gokberkkatirci/CAN-and-isoSPI-Adapter/docs/images/board-r0a.png

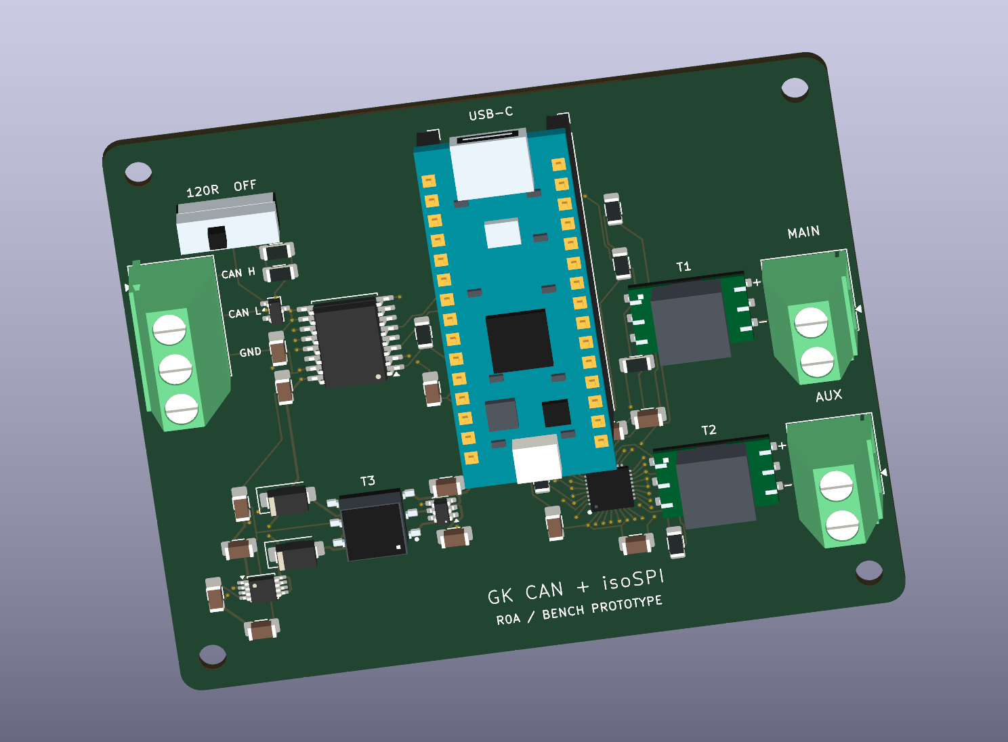
docs/images/board-r0a.png
