gokberkkatirci/CAN-and-isoSPI-Adapter/docs/images/board-r0b.png

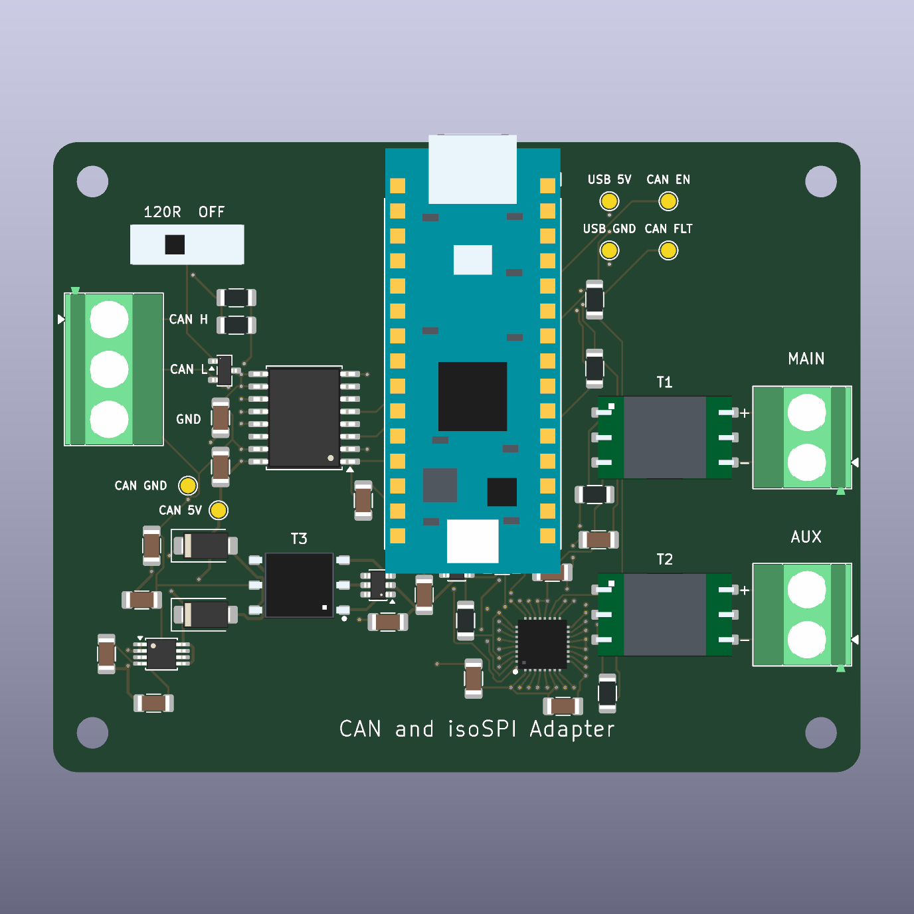
docs/images/board-r0b.png
