gokberkkatirci/CAN-and-isoSPI-Adapter/docs/images/board-r0c.png

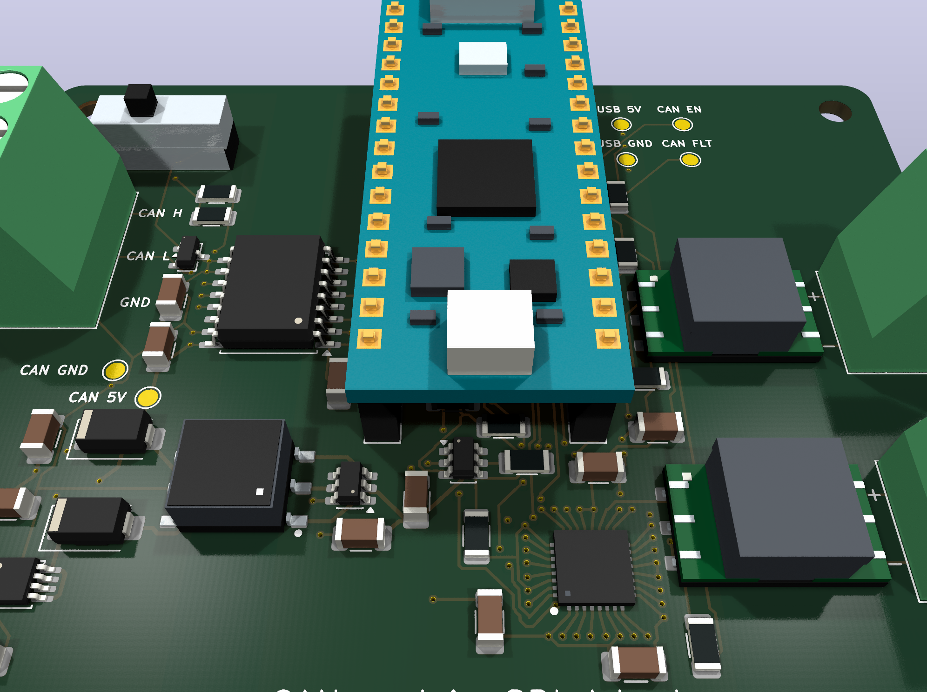
docs/images/board-r0c.png
