gokberkkatirci/CAN-and-isoSPI-Adapter/manufacturing/prototype/T41-R0A/bom-jlcpcb.csv

Comment | Designator | Footprint | JLCPCB Part #
CL31A106KBHNNNE | C1,C4,C103,C105,C106,C203,C205,C206,C303,C305,C306,C403,C405,C406,C503,C505,C506,C603,C605,C606 | C_1206_3216Metric | C13585
CL31B104KBCNNNC | C2,C5,C102,C104,C107,C108,C109,C202,C204,C207,C208,C209,C302,C304,C307,C308,C309,C402,C404,C407,C408,C409,C412,C502,C504,C507,C508,C509,C512,C602,C604,C607,C608,C609,C612,C701,C702,C704,C706,C801,C802,C804,C806,C901,C902,C904,C906 | C_1206_3216Metric | C24497
1206B472K202NT | C3,C101,C201,C301,C401,C501,C601 | C_1206_3216Metric | C41017
CC1206JKNPOCBN220 | C410,C411,C510,C511,C610,C611 | C_1206_3216Metric | C107174
CL31B105KBHNNNE | C703,C705,C803,C805,C903,C905 | C_1206_3216Metric | C1848
SMAJ5.0A | D1 | D_SMA | C83329
B5819W SL | D2,D101,D102,D201,D202,D301,D302,D401,D402,D501,D502,D601,D602 | D_SOD-123 | C8598
KT-1206G | D3,D4,D104,D204,D304,D404,D504,D604 | LED_1206_3216Metric | C14641
KT-1206R | D5 | LED_1206_3216Metric | C49018
PESD2CANFD24V-TR | D103,D203,D303,D403,D503,D603 | SOT-23 | C552486
1206L200PR | F1 | Fuse_1206_3216Metric | C151163
TYPE-C-31-M-12 | J1 | USB_C_Receptacle_HRO_TYPE-C-31-M-12 | C165948
HC-PM254-8.5H-1x24PZ | J2,J3 | PinSocket_1x24_P2.54mm_Vertical | C41376163
YTC1P-8535-01 | J4,J5 | Pogo_YTC1P-8535_D2.0mm | C5221289
DS1034-09FBN044 | J101,J201,J301,J401,J501,J601 | DSUB-9_Socket_Vertical_P2.77x2.84mm_MountingHoles | C19268322
1715721 | J701,J702,J801,J802,J901,J902 | TerminalBlock_Phoenix_MKDS-1,5-2-5.08_1x02_P5.08mm_Horizontal | C480516
1206W4F5101T5E | R1,R2 | R_1206_3216Metric | C26033
1206W4F1001T5E | R3,R4,R7,R8 | R_1206_3216Metric | C4410
1206W4F1004T5E | R5,R103,R203,R303,R403,R503,R603 | R_1206_3216Metric | C17927
1206W4F2201T5E | R6,R107,R207,R307,R407,R507,R607 | R_1206_3216Metric | C17948
1206W4F1002T5E | R9,R106,R206,R306,R406,R408,R409,R506,R508,R509,R606,R608,R609,R701,R702,R801,R802,R901,R902 | R_1206_3216Metric | C17902
1206W4F2400T5E | R101,R102,R201,R202,R301,R302,R401,R402,R501,R502,R601,R602 | R_1206_3216Metric | C17961
1206W4F1303T5E | R104,R204,R304,R404,R504,R604 | R_1206_3216Metric | C82092
1206W4F1003T5E | R105,R205,R305,R405,R505,R605 | R_1206_3216Metric | C17900
1206W4F1000T5E | R703,R704,R803,R804,R903,R904 | R_1206_3216Metric | C17901
EG1218 | SW101,SW201,SW301,SW401,SW501,SW601 | EG1218 | C273394
760390014 | T101,T201,T301,T401,T501,T601 | WE_760390014 | C2802211
SM91801AL-E | T701,T702,T801,T802,T901,T902 | SM91801AL-E | C26423704
USBLC6-2SC6 | U1 | SOT-23-6 | C7519
ISO1042DWR | U101,U201,U301,U401,U501,U601 | SOIC-16W_7.5x10.3mm_P1.27mm | C1848126
TPS2553DBVR | U102,U202,U302,U402,U502,U602 | SOT-23-6 | C55266
SN6505BDBVR | U103,U203,U303,U403,U503,U603 | SOT-23-6 | C74518
TLV76750DGNR | U104,U204,U304,U404,U504,U604 | MSOP-8-1EP_3x3mm_P0.65mm_EP1.73x1.85mm | C3752807
MCP2518FDT-E/SL | U405,U505,U605 | SOIC-14_3.9x8.7mm_P1.27mm | C626758
ADBMS6822WCCSZ-RL | U701,U801,U901 | ADBMS6822_05-08-7057 | C19190031
X322540MPB4SI | Y401,Y501,Y601 | Crystal_SMD_3225-4Pin_3.2x2.5mm | C9010
