gokberkkatirci/CAN-and-isoSPI-Adapter/hardware/teensy41/CAN6_isoSPI6_T41.kicad_pcb

## KiCad design hardware/teensy41/CAN6_isoSPI6_T41.kicad_pcb (2026-11-09)

Schematic: CAN6_isoSPI6_T41.kicad_sch, Six CAN and six isoSPI adapter - Teensy 4.1

Parts:
C1, C4, C103, C105, C106, C203, C205, C206, C303, C305, C306, C403, C405, C406, C503, C505, C506, C603, C605, C606: 10uF; C_1206_3216Metric; MPN CL31A106KBHNNNE; JLCPCB Part # C13585
C2, C5, C102, C104, C107, C108, C109, C202, C204, C207, C208, C209, C302, C304, C307, C308, C309, C402, C404, C407, C408, C409, C412, C502, C504, C507, C508, C509, C512, C602, C604, C607, C608, C609, C612, C701, C702, C704, C706, C801, C802, C804, C806, C901, C902, C904, C906: 100nF; C_1206_3216Metric; MPN CL31B104KBCNNNC; JLCPCB Part # C24497
C3, C101, C201, C301, C401, C501, C601: 4.7nF 2kV; C_1206_3216Metric; MPN 1206B472K202NT; JLCPCB Part # C41017
C410, C411, C510, C511, C610, C611: 22pF; C_1206_3216Metric; MPN CC1206JKNPOCBN220; JLCPCB Part # C107174
C703, C705, C803, C805, C903, C905: 1uF; C_1206_3216Metric; MPN CL31B105KBHNNNE; JLCPCB Part # C1848
D1: SMAJ5.0A; D_SMA; MPN SMAJ5.0A; JLCPCB Part # C83329
D2, D101, D102, D201, D202, D301, D302, D401, D402, D501, D502, D601, D602: B5819W; D_SOD-123; MPN B5819W SL; JLCPCB Part # C8598
D3, D4, D104, D204, D304, D404, D504, D604: Green; LED_1206_3216Metric; MPN KT-1206G; JLCPCB Part # C14641
D5: Red; LED_1206_3216Metric; MPN KT-1206R; JLCPCB Part # C49018
D103, D203, D303, D403, D503, D603: PESD2CANFD24V-TR; SOT-23; MPN PESD2CANFD24V-TR; JLCPCB Part # C552486
F1: 2A PTC; Fuse_1206_3216Metric; MPN 1206L200PR; JLCPCB Part # C151163
H1, H2, H3, H4, H5, H6: M3 mounting hole; MountingHole_3.2mm_M3
J1: USB-C; USB_C_Receptacle_HRO_TYPE-C-31-M-12; MPN TYPE-C-31-M-12; JLCPCB Part # C165948
J2: Teensy 4.1 row GND-0-32; PinSocket_1x24_P2.54mm_Vertical; MPN HC-PM254-8.5H-1x24PZ; JLCPCB Part # C41376163
J3: Teensy 4.1 row VIN-23-33; PinSocket_1x24_P2.54mm_Vertical; MPN HC-PM254-8.5H-1x24PZ; JLCPCB Part # C41376163
J4: Pogo USB D-; Pogo_YTC1P-8535_D2.0mm; MPN YTC1P-8535-01; JLCPCB Part # C5221289
J5: Pogo USB D+; Pogo_YTC1P-8535_D2.0mm; MPN YTC1P-8535-01; JLCPCB Part # C5221289
J101: CAN1 DSUB-9F; DSUB-9_Socket_Vertical_P2.77x2.84mm_MountingHoles; MPN DS1034-09FBN044; JLCPCB Part # C19268322
J201: CAN2 DSUB-9F; DSUB-9_Socket_Vertical_P2.77x2.84mm_MountingHoles; MPN DS1034-09FBN044; JLCPCB Part # C19268322
J301: CAN3 DSUB-9F; DSUB-9_Socket_Vertical_P2.77x2.84mm_MountingHoles; MPN DS1034-09FBN044; JLCPCB Part # C19268322
J401: CAN4 DSUB-9F; DSUB-9_Socket_Vertical_P2.77x2.84mm_MountingHoles; MPN DS1034-09FBN044; JLCPCB Part # C19268322
J501: CAN5 DSUB-9F; DSUB-9_Socket_Vertical_P2.77x2.84mm_MountingHoles; MPN DS1034-09FBN044; JLCPCB Part # C19268322
J601: CAN6 DSUB-9F; DSUB-9_Socket_Vertical_P2.77x2.84mm_MountingHoles; MPN DS1034-09FBN044; JLCPCB Part # C19268322
J701: isoSPI 1; TerminalBlock_Phoenix_MKDS-1,5-2-5.08_1x02_P5.08mm_Horizont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; MPN 1715721; JLCPCB Part # C480516
J702: isoSPI 2; TerminalBlock_Phoenix_MKDS-1,5-2-5.08_1x02_P5.08mm_Horizont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; MPN 1715721; JLCPCB Part # C480516
J801: isoSPI 3; TerminalBlock_Phoenix_MKDS-1,5-2-5.08_1x02_P5.08mm_Horizont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; MPN 1715721; JLCPCB Part # C480516
J802: isoSPI 4; TerminalBlock_Phoenix_MKDS-1,5-2-5.08_1x02_P5.08mm_Horizont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; MPN 1715721; JLCPCB Part # C480516
J901: isoSPI 5; TerminalBlock_Phoenix_MKDS-1,5-2-5.08_1x02_P5.08mm_Horizont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; MPN 1715721; JLCPCB Part # C480516
J902: isoSPI 6; TerminalBlock_Phoenix_MKDS-1,5-2-5.08_1x02_P5.08mm_Horizont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; MPN 1715721; JLCPCB Part # C480516
R1, R2: 5.1k; R_1206_3216Metric; MPN 1206W4F5101T5E; JLCPCB Part # C26033
R3, R4, R7, R8: 1k; R_1206_3216Metric; MPN 1206W4F1001T5E; JLCPCB Part # C4410
R5, R103, R203, R303, R403, R503, R603: 1M; R_1206_3216Metric; MPN 1206W4F1004T5E; JLCPCB Part # C17927
R6, R107, R207, R307, R407, R507, R607: 2.2k; R_1206_3216Metric; MPN 1206W4F2201T5E; JLCPCB Part # C17948
R9, R106, R206, R306, R406, R408, R409, R506, R508, R509, R606, R608, R609, R701, R702, R801, R802, R901, R902: 10k; R_1206_3216Metric; MPN 1206W4F1002T5E; JLCPCB Part # C17902
R101, R102, R201, R202, R301, R302, R401, R402, R501, R502, R601, R602: 240R; R_1206_3216Metric; MPN 1206W4F2400T5E; JLCPCB Part # C17961
R104, R204, R304, R404, R504, R604: 130k; R_1206_3216Metric; MPN 1206W4F1303T5E; JLCPCB Part # C82092
R105, R205, R305, R405, R505, R605: 100k; R_1206_3216Metric; MPN 1206W4F1003T5E; JLCPCB Part # C17900
R703, R704, R803, R804, R903, R904: 100R; R_1206_3216Metric; MPN 1206W4F1000T5E; JLCPCB Part # C17901
SW101, SW201, SW301, SW401, SW501, SW601: 120R termination; EG1218; MPN EG1218; JLCPCB Part # C273394
T101, T201, T301, T401, T501, T601: 760390014; WE_760390014; MPN 760390014; JLCPCB Part # C2802211
T701, T702, T801, T802, T901, T902: SM91801AL-E; MPN SM91801AL-E; JLCPCB Part # C26423704
TP1, TP2, TP3, TP4, TP5, TP6, TP7, TP8, TP9, TP10, TP11, TP12, TP13, TP14, TP15, TP16: Test pad; TestPoint_Pad_D1.5mm
U1: USBLC6-2SC6; SOT-23-6; MPN USBLC6-2SC6; JLCPCB Part # C7519
U101, U201, U301, U401, U501, U601: ISO1042DWR; SOIC-16W_7.5x10.3mm_P1.27mm; MPN ISO1042DWR; JLCPCB Part # C1848126
U102, U202, U302, U402, U502, U602: TPS2553DBVR; SOT-23-6; MPN TPS2553DBVR; JLCPCB Part # C55266
U103, U203, U303, U403, U503, U603: SN6505BDBVR; SOT-23-6; MPN SN6505BDBVR; JLCPCB Part # C74518
U104, U204, U304, U404, U504, U604: TLV76750DGNR; MSOP-8-1EP_3x3mm_P0.65mm_EP1.73x1.85mm; MPN TLV76750DGNR; JLCPCB Part # C3752807
U405, U505, U605: MCP2518FDT-E/SL; SOIC-14_3.9x8.7mm_P1.27mm; MPN MCP2518FDT-E/SL; JLCPCB Part # C626758
U701, U801, U901: ADBMS6822WCCSZ-RL; ADBMS6822_05-08-7057; MPN ADBMS6822WCCSZ-RL; JLCPCB Part # C19190031
Y401, Y501, Y601: 40MHz; Crystal_SMD_3225-4Pin_3.2x2.5mm; MPN X322540MPB4SI; JLCPCB Part # C9010

Connections:
/+3V3: C4.1, C5.1, C109.1, C209.1, C309.1, C409.1, C412.1, C509.1, C512.1, C609.1, C612.1, C701.1, C702.1, C801.1, C802.1, C901.1, C902.1, J2.15 (3V3), J3.3 (3V3), R9.2, R106.2, R206.2, R306.2, R406.2, R408.2, R409.2, R506.2, R508.2, R509.2, R606.2, R608.2, R609.2, R701.2, R702.2, R801.2, R802.2, R901.2, R902.2, TP3.1, U101.1 (VCC1), U201.1 (VCC1), U301.1 (VCC1), U401.1 (VCC1), U405.14 (VDD), U501.1 (VCC1), U505.14 (VDD), U601.1 (VCC1), U605.14 (VDD), U701.1 (MSTR), U701.6 (VDDS), U701.25 (MSTR2), U701.30 (VDDS2), U801.1 (MSTR), U801.6 (VDDS), U801.25 (MSTR2), U801.30 (VDDS2), U901.1 (MSTR), U901.6 (VDDS), U901.25 (MSTR2), U901.30 (VDDS2)
/+5V: C1.1, C2.1, C102.1, C202.1, C302.1, C402.1, C502.1, C602.1, C703.1, C704.1, C705.1, C706.1, C803.1, C804.1, C805.1, C806.1, C903.1, C904.1, C905.1, C906.1, D1.1 (K), D2.2 (A), F1.2, R6.1, TP1.1, U102.1 (IN), U202.1 (IN), U302.1 (IN), U402.1 (IN), U502.1 (IN), U602.1 (IN), U701.12 (VDD), U701.13 (VP), U701.20 (VDD2), U701.21 (VP2), U801.12 (VDD), U801.13 (VP), U801.20 (VDD2), U801.21 (VP2), U901.12 (VDD), U901.13 (VP), U901.20 (VDD2), U901.21 (VP2)
/CAN1I_5V: C106.1, C107.1, C108.1, R107.1, U101.11 (VCC2), U101.16 (VCC2), U104.1 (OUT), U104.2 (SNS)
/CAN1I_GND: C101.2, C105.2, C106.2, C107.2, C108.2, D103.3 (COMMON), D104.1 (K), J101.3 (CAN_GND), J101.6 (CAN_GND), R103.2, T101.5 (SEC_CT), U101.9 (GND2), U101.10 (GND2), U101.15 (GND2), U104.4 (GND), U104.6 (GND), U104.9 (EP)
/CAN1I_H: D103.1 (IO1), J101.7 (CAN_H), SW101.2 (COM), U101.13 (CANH)
/CAN1I_L: D103.2 (IO2), J101.2 (CAN_L), R101.2, R102.2, U101.12 (CANL)
/CAN1I_LED: D104.2 (A), R107.2
/CAN1I_RA: D101.2 (A), T101.6 (SEC1)
/CAN1I_RB: D102.2 (A), T101.4 (SEC2)
/CAN1I_RECT: C105.1, D101.1 (K), D102.1 (K), U104.5 (EN), U104.8 (IN)
/CAN1I_SHLD: C101.1, J101.5 (SHLD), J101.SH (SHELL), R103.1
/CAN1I_TERM: R101.1, R102.1, SW101.1 (ON)
/CAN1_EN: J3.10 (D17), R105.1, U102.3 (EN)
/CAN1_ILIM: R104.1, U102.5 (ILIM)
/CAN1_PPA: T101.3 (PRI2), U103.1 (D1)
/CAN1_PPB: T101.1 (PRI1), U103.3 (D2)
/CAN1_PWR: C103.1, C104.1, T101.2 (PRI_CT), U102.6 (OUT), U103.2 (VCC), U103.5 (EN)
/CAN1_RX: J3.4 (D23), TP13.1, U101.5 (RXD)
/CAN1_TX: J3.5 (D22), R106.1, TP12.1, U101.3 (TXD)
/CAN2I_5V: C206.1, C207.1, C208.1, R207.1, U201.11 (VCC2), U201.16 (VCC2), U204.1 (OUT), U204.2 (SNS)
/CAN2I_GND: C201.2, C205.2, C206.2, C207.2, C208.2, D203.3 (COMMON), D204.1 (K), J201.3 (CAN_GND), J201.6 (CAN_GND), R203.2, T201.5 (SEC_CT), U201.9 (GND2), U201.10 (GND2), U201.15 (GND2), U204.4 (GND), U204.6 (GND), U204.9 (EP)
/CAN2I_H: D203.1 (IO1), J201.7 (CAN_H), SW201.2 (COM), U201.13 (CANH)
/CAN2I_L: D203.2 (IO2), J201.2 (CAN_L), R201.2, R202.2, U201.12 (CANL)
/CAN2I_LED: D204.2 (A), R207.2
/CAN2I_RA: D201.2 (A), T201.6 (SEC1)
/CAN2I_RB: D202.2 (A), T201.4 (SEC2)
/CAN2I_RECT: C205.1, D201.1 (K), D202.1 (K), U204.5 (EN), U204.8 (IN)
/CAN2I_SHLD: C201.1, J201.5 (SHLD), J201.SH (SHELL), R203.1
/CAN2I_TERM: R201.1, R202.1, SW201.1 (ON)
/CAN2_EN: J3.9 (D18), R205.1, U202.3 (EN)
/CAN2_ILIM: R204.1, U202.5 (ILIM)
/CAN2_PPA: T201.3 (PRI2), U203.1 (D1)
/CAN2_PPB: T201.1 (PRI1), U203.3 (D2)
/CAN2_PWR: C203.1, C204.1, T201.2 (PRI_CT), U202.6 (OUT), U203.2 (VCC), U203.5 (EN)
/CAN2_RX: J2.2 (D0), U201.5 (RXD)
/CAN2_TX: J2.3 (D1), R206.1, U201.3 (TXD)
/CAN3I_5V: C306.1, C307.1, C308.1, R307.1, U301.11 (VCC2), U301.16 (VCC2), U304.1 (OUT), U304.2 (SNS)
/CAN3I_GND: C301.2, C305.2, C306.2, C307.2, C308.2, D303.3 (COMMON), D304.1 (K), J301.3 (CAN_GND), J301.6 (CAN_GND), R303.2, T301.5 (SEC_CT), U301.9 (GND2), U301.10 (GND2), U301.15 (GND2), U304.4 (GND), U304.6 (GND), U304.9 (EP)
/CAN3I_H: D303.1 (IO1), J301.7 (CAN_H), SW301.2 (COM), U301.13 (CANH)
/CAN3I_L: D303.2 (IO2), J301.2 (CAN_L), R301.2, R302.2, U301.12 (CANL)
/CAN3I_LED: D304.2 (A), R307.2
/CAN3I_RA: D301.2 (A), T301.6 (SEC1)
/CAN3I_RB: D302.2 (A), T301.4 (SEC2)
/CAN3I_RECT: C305.1, D301.1 (K), D302.1 (K), U304.5 (EN), U304.8 (IN)
/CAN3I_SHLD: C301.1, J301.5 (SHLD), J301.SH (SHELL), R303.1
/CAN3I_TERM: R301.1, R302.1, SW301.1 (ON)
/CAN3_EN: J3.8 (D19), R305.1, U302.3 (EN)
/CAN3_ILIM: R304.1, U302.5 (ILIM)
/CAN3_PPA: T301.3 (PRI2), U303.1 (D1)
/CAN3_PPB: T301.1 (PRI1), U303.3 (D2)
/CAN3_PWR: C303.1, C304.1, T301.2 (PRI_CT), U302.6 (OUT), U303.2 (VCC), U303.5 (EN)
/CAN3_RX: J2.22 (D30), U301.5 (RXD)
/CAN3_TX: J2.23 (D31), R306.1, U301.3 (TXD)
/CAN4I_5V: C406.1, C407.1, C408.1, R407.1, U401.11 (VCC2), U401.16 (VCC2), U404.1 (OUT), U404.2 (SNS)
/CAN4I_GND: C401.2, C405.2, C406.2, C407.2, C408.2, D403.3 (COMMON), D404.1 (K), J401.3 (CAN_GND), J401.6 (CAN_GND), R403.2, T401.5 (SEC_CT), U401.9 (GND2), U401.10 (GND2), U401.15 (GND2), U404.4 (GND), U404.6 (GND), U404.9 (EP)
/CAN4I_H: D403.1 (IO1), J401.7 (CAN_H), SW401.2 (COM), U401.13 (CANH)
/CAN4I_L: D403.2 (IO2), J401.2 (CAN_L), R401.2, R402.2, U401.12 (CANL)
/CAN4I_LED: D404.2 (A), R407.2
/CAN4I_RA: D401.2 (A), T401.6 (SEC1)
/CAN4I_RB: D402.2 (A), T401.4 (SEC2)
/CAN4I_RECT: C405.1, D401.1 (K), D402.1 (K), U404.5 (EN), U404.8 (IN)
/CAN4I_SHLD: C401.1, J401.5 (SHLD), J401.SH (SHELL), R403.1
/CAN4I_TERM: R401.1, R402.1, SW401.1 (ON)
/CAN4_EN: J3.7 (D20), R405.1, U402.3 (EN)
/CAN4_ILIM: R404.1, U402.5 (ILIM)
/CAN4_PPA: T401.3 (PRI2), U403.1 (D1)
/CAN4_PPB: T401.1 (PRI1), U403.3 (D2)
/CAN4_PWR: C403.1, C404.1, T401.2 (PRI_CT), U402.6 (OUT), U403.2 (VCC), U403.5 (EN)
/CAN4_RX: U401.5 (RXD), U405.2 (RXCAN)
/CAN4_TX: R406.1, U401.3 (TXD), U405.1 (TXCAN)
/CAN4_XI: C410.1, U405.6 (OSC1), Y401.1 (X1)
/CAN4_XO: C411.1, U405.5 (OSC2), Y401.3 (X2)
/CAN5I_5V: C506.1, C507.1, C508.1, R507.1, U501.11 (VCC2), U501.16 (VCC2), U504.1 (OUT), U504.2 (SNS)
/CAN5I_GND: C501.2, C505.2, C506.2, C507.2, C508.2, D503.3 (COMMON), D504.1 (K), J501.3 (CAN_GND), J501.6 (CAN_GND), R503.2, T501.5 (SEC_CT), U501.9 (GND2), U501.10 (GND2), U501.15 (GND2), U504.4 (GND), U504.6 (GND), U504.9 (EP)
/CAN5I_H: D503.1 (IO1), J501.7 (CAN_H), SW501.2 (COM), U501.13 (CANH)
/CAN5I_L: D503.2 (IO2), J501.2 (CAN_L), R501.2, R502.2, U501.12 (CANL)
/CAN5I_LED: D504.2 (A), R507.2
/CAN5I_RA: D501.2 (A), T501.6 (SEC1)
/CAN5I_RB: D502.2 (A), T501.4 (SEC2)
/CAN5I_RECT: C505.1, D501.1 (K), D502.1 (K), U504.5 (EN), U504.8 (IN)
/CAN5I_SHLD: C501.1, J501.5 (SHLD), J501.SH (SHELL), R503.1
/CAN5I_TERM: R501.1, R502.1, SW501.1 (ON)
/CAN5_EN: J3.6 (D21), R505.1, U502.3 (EN)
/CAN5_ILIM: R504.1, U502.5 (ILIM)
/CAN5_PPA: T501.3 (PRI2), U503.1 (D1)
/CAN5_PPB: T501.1 (PRI1), U503.3 (D2)
/CAN5_PWR: C503.1, C504.1, T501.2 (PRI_CT), U502.6 (OUT), U503.2 (VCC), U503.5 (EN)
/CAN5_RX: U501.5 (RXD), U505.2 (RXCAN)
/CAN5_TX: R506.1, U501.3 (TXD), U505.1 (TXCAN)
/CAN5_XI: C510.1, U505.6 (OSC1), Y501.1 (X1)
/CAN5_XO: C511.1, U505.5 (OSC2), Y501.3 (X2)
/CAN6I_5V: C606.1, C607.1, C608.1, R607.1, U601.11 (VCC2), U601.16 (VCC2), U604.1 (OUT), U604.2 (SNS)
/CAN6I_GND: C601.2, C605.2, C606.2, C607.2, C608.2, D603.3 (COMMON), D604.1 (K), J601.3 (CAN_GND), J601.6 (CAN_GND), R603.2, T601.5 (SEC_CT), U601.9 (GND2), U601.10 (GND2), U601.15 (GND2), U604.4 (GND), U604.6 (GND), U604.9 (EP)
/CAN6I_H: D603.1 (IO1), J601.7 (CAN_H), SW601.2 (COM), U601.13 (CANH)
/CAN6I_L: D603.2 (IO2), J601.2 (CAN_L), R601.2, R602.2, U601.12 (CANL)
/CAN6I_LED: D604.2 (A), R607.2
/CAN6I_RA: D601.2 (A), T601.6 (SEC1)
/CAN6I_RB: D602.2 (A), T601.4 (SEC2)
/CAN6I_RECT: C605.1, D601.1 (K), D602.1 (K), U604.5 (EN), U604.8 (IN)
/CAN6I_SHLD: C601.1, J601.5 (SHLD), J601.SH (SHELL), R603.1
/CAN6I_TERM: R601.1, R602.1, SW601.1 (ON)
/CAN6_EN: J2.16 (D24), R605.1, U602.3 (EN)
/CAN6_ILIM: R604.1, U602.5 (ILIM)
/CAN6_PPA: T601.3 (PRI2), U603.1 (D1)
/CAN6_PPB: T601.1 (PRI1), U603.3 (D2)
/CAN6_PWR: C603.1, C604.1, T601.2 (PRI_CT), U602.6 (OUT), U603.2 (VCC), U603.5 (EN)
/CAN6_RX: U601.5 (RXD), U605.2 (RXCAN)
/CAN6_TX: R606.1, U601.3 (TXD), U605.1 (TXCAN)
/CAN6_XI: C610.1, U605.6 (OSC1), Y601.1 (X1)
/CAN6_XO: C611.1, U605.5 (OSC2), Y601.3 (X2)
/CAN_PWR_FAULT: J2.17 (D25), R9.1, TP5.1, U102.4 (FAULT), U202.4 (FAULT), U302.4 (FAULT), U402.4 (FAULT), U502.4 (FAULT), U602.4 (FAULT)
/CC1_SENSE: J3.17 (D40), R3.2
/CC2_SENSE: J3.16 (D41), R4.2
/GND: C1.2, C2.2, C3.2, C4.2, C5.2, C102.2, C103.2, C104.2, C109.2, C202.2, C203.2, C204.2, C209.2, C302.2, C303.2, C304.2, C309.2, C402.2, C403.2, C404.2, C409.2, C410.2, C411.2, C412.2, C502.2, C503.2, C504.2, C509.2, C510.2, C511.2, C512.2, C602.2, C603.2, C604.2, C609.2, C610.2, C611.2, C612.2, C701.2, C702.2, C703.2, C704.2, C705.2, C706.2, C801.2, C802.2, C803.2, C804.2, C805.2, C806.2, C901.2, C902.2, C903.2, C904.2, C905.2, C906.2, D1.2 (A), D3.1 (K), D4.1 (K), D5.1 (K), J1.A1 (GND), J1.A12 (GND), J1.B1 (GND), J1.B12 (GND), J2.1 (GND), J3.2 (GND), J3.15 (GND), R1.2, R2.2, R5.2, R104.2, R105.2, R204.2, R205.2, R304.2, R305.2, R404.2, R405.2, R504.2, R505.2, R604.2, R605.2, TP2.1, U1.2 (GND), U101.2 (GND1), U101.8 (GND1), U102.2 (GND), U103.4 (GND), U103.6 (CLK), U201.2 (GND1), U201.8 (GND1), U202.2 (GND), U203.4 (GND), U203.6 (CLK), U301.2 (GND1), U301.8 (GND1), U302.2 (GND), U303.4 (GND), U303.6 (CLK), U401.2 (GND1), U401.8 (GND1), U402.2 (GND), U403.4 (GND), U403.6 (CLK), U405.7 (VSS), U501.2 (GND1), U501.8 (GND1), U502.2 (GND), U503.4 (GND), U503.6 (CLK), U505.7 (VSS), U601.2 (GND1), U601.8 (GND1), U602.2 (GND), U603.4 (GND), U603.6 (CLK), U605.7 (VSS), U701.9 (GND), U701.14 (PHAPOL), U701.15 (RTO), U701.16 (XCVRMD), U701.17 (GND2), U701.22 (PHAPOL2), U701.23 (RTO2), U701.24 (XCVRMD2), U701.33 (EP), U801.9 (GND), U801.14 (PHAPOL), U801.15 (RTO), U801.16 (XCVRMD), U801.17 (GND2), U801.22 (PHAPOL2), U801.23 (RTO2), U801.24 (XCVRMD2), U801.33 (EP), U901.9 (GND), U901.14 (PHAPOL), U901.15 (RTO), U901.16 (XCVRMD), U901.17 (GND2), U901.22 (PHAPOL2), U901.23 (RTO2), U901.24 (XCVRMD2), U901.33 (EP), Y401.2 (GND), Y401.4 (GND), Y501.2 (GND), Y501.4 (GND), Y601.2 (GND), Y601.4 (GND)
/ISO1C_N: J701.1 (-), T701.4 (SEC-)
/ISO1C_P: J701.2 (+), T701.6 (SEC+)
/ISO1_IM: R703.2, T701.3 (PRI-), U701.18 (IM2)
/ISO1_IP: R703.1, T701.1 (PRI+), U701.19 (IP2)
/ISO2C_N: J702.1 (-), T702.4 (SEC-)
/ISO2C_P: J702.2 (+), T702.6 (SEC+)
/ISO2_IM: R704.2, T702.3 (PRI-), U701.10 (IM)
/ISO2_IP: R704.1, T702.1 (PRI+), U701.11 (IP)
/ISO3C_N: J801.1 (-), T801.4 (SEC-)
/ISO3C_P: J801.2 (+), T801.6 (SEC+)
/ISO3_IM: R803.2, T801.3 (PRI-), U801.18 (IM2)
/ISO3_IP: R803.1, T801.1 (PRI+), U801.19 (IP2)
/ISO4C_N: J802.1 (-), T802.4 (SEC-)
/ISO4C_P: J802.2 (+), T802.6 (SEC+)
/ISO4_IM: R804.2, T802.3 (PRI-), U801.10 (IM)
/ISO4_IP: R804.1, T802.1 (PRI+), U801.11 (IP)
/ISO5C_N: J901.1 (-), T901.4 (SEC-)
/ISO5C_P: J901.2 (+), T901.6 (SEC+)
/ISO5_IM: R903.2, T901.3 (PRI-), U901.18 (IM2)
/ISO5_IP: R903.1, T901.1 (PRI+), U901.19 (IP2)
/ISO6C_N: J902.1 (-), T902.4 (SEC-)
/ISO6C_P: J902.2 (+), T902.6 (SEC+)
/ISO6_IM: R904.2, T902.3 (PRI-), U901.10 (IM)
/ISO6_IP: R904.1, T902.1 (PRI+), U901.11 (IP)
/ISO_CS1: J2.12 (D10), R702.1, U701.29 (CS2)
/ISO_CS2: J2.11 (D9), R701.1, U701.5 (CS)
/ISO_CS3: J2.10 (D8), R802.1, U801.29 (CS2)
/ISO_CS4: J2.9 (D7), R801.1, U801.5 (CS)
/ISO_CS5: J2.8 (D6), R902.1, U901.29 (CS2)
/ISO_CS6: J2.7 (D5), R901.1, U901.5 (CS)
/ISO_INT1: J2.4 (D2), U701.31 (INTR2)
/ISO_INT2: J2.5 (D3), U701.7 (INTR)
/ISO_INT3: J2.6 (D4), U801.31 (INTR2)
/ISO_INT4: J3.13 (D14), U801.7 (INTR)
/ISO_INT5: J3.12 (D15), U901.31 (INTR2)
/ISO_INT6: J3.11 (D16), U901.7 (INTR)
/ISO_MISO: J2.14 (D12), TP10.1, U701.3 (POCI), U701.27 (POCI2), U801.3 (POCI), U801.27 (POCI2), U901.3 (POCI), U901.27 (POCI2)
/ISO_MOSI: J2.13 (D11), TP9.1, U701.2 (PICO), U701.26 (PICO2), U801.2 (PICO), U801.26 (PICO2), U901.2 (PICO), U901.26 (PICO2)
/ISO_SCK: J3.14 (D13), TP11.1, U701.4 (SCK), U701.28 (SCK2), U801.4 (SCK), U801.28 (SCK2), U901.4 (SCK), U901.28 (SCK2)
/LED_5V_A: D3.2 (A), R6.2
/LED_ERR: J2.21 (D29), R8.1
/LED_ERR_A: D5.2 (A), R8.2
/LED_OK: J2.20 (D28), R7.1
/LED_OK_A: D4.2 (A), R7.2
/MCP_CS4: J3.19 (D38), R408.1, U405.13 (nCS)
/MCP_CS5: J3.20 (D37), R508.1, U505.13 (nCS)
/MCP_CS6: J3.21 (D36), R608.1, U605.13 (nCS)
/MCP_INT4: J3.22 (D35), R409.1, U405.4 (nINT)
/MCP_INT5: J3.23 (D34), R509.1, U505.4 (nINT)
/MCP_INT6: J3.24 (D33), R609.1, U605.4 (nINT)
/MCP_MISO: J3.18 (D39), TP15.1, U405.12 (SDO), U505.12 (SDO), U605.12 (SDO)
/MCP_MOSI: J2.18 (D26), TP14.1, U405.11 (SDI), U505.11 (SDI), U605.11 (SDI)
/MCP_SCK: J2.19 (D27), TP16.1, U405.10 (SCK), U505.10 (SCK), U605.10 (SCK)
/T_SPARE32: J2.24 (D32), TP6.1
/T_VIN: D2.1 (K), J3.1 (VIN)
/USB_CC1: J1.A5 (CC1), R1.1, R3.1
/USB_CC2: J1.B5 (CC2), R2.1, R4.1
/USB_DM: J1.A7 (D-), J1.B7 (D-), J4.1, TP8.1, U1.3 (IO2), U1.4 (IO2)
/USB_DP: J1.A6 (D+), J1.B6 (D+), J5.1, TP7.1, U1.1 (IO1), U1.6 (IO1)
/USB_SHIELD: C3.1, J1.SH (SHIELD), R5.1
/VBUS: F1.1, J1.A4 (VBUS), J1.A9 (VBUS), J1.B4 (VBUS), J1.B9 (VBUS), TP4.1, U1.5 (VBUS)

Notes on the sheet:
Power and USB
Teensy 4.1
isoSPI 1-2
isoSPI 3-4
isoSPI 5-6
CAN1
CAN2
CAN3
CAN4
CAN5
CAN6
Teensy 4.1 sits in J2/J3 (8.5 mm sockets). Cut the VIN-VUSB pads on the Teensy so USB power enters only through J1/F1/D2.
J4/J5 pogo pins reach the Teensy USB device D-/D+ pads under the module; the carrier USB-C carries data and power.
CAN1-3 use Teensy FlexCAN1-3; CAN4-6 use MCP2518FD on SPI1. Each CAN port has its own isolated supply and ground.
DSUB-9 female, CiA 303-1 / PEAK pinout: 2 CAN_L, 7 CAN_H, 3 and 6 CAN_GND, 5 and shell to shield RC.
isoSPI ports use SM91801AL-E (1000 V DC working, basic insulation). Keep 8 mm copper clearance per port.

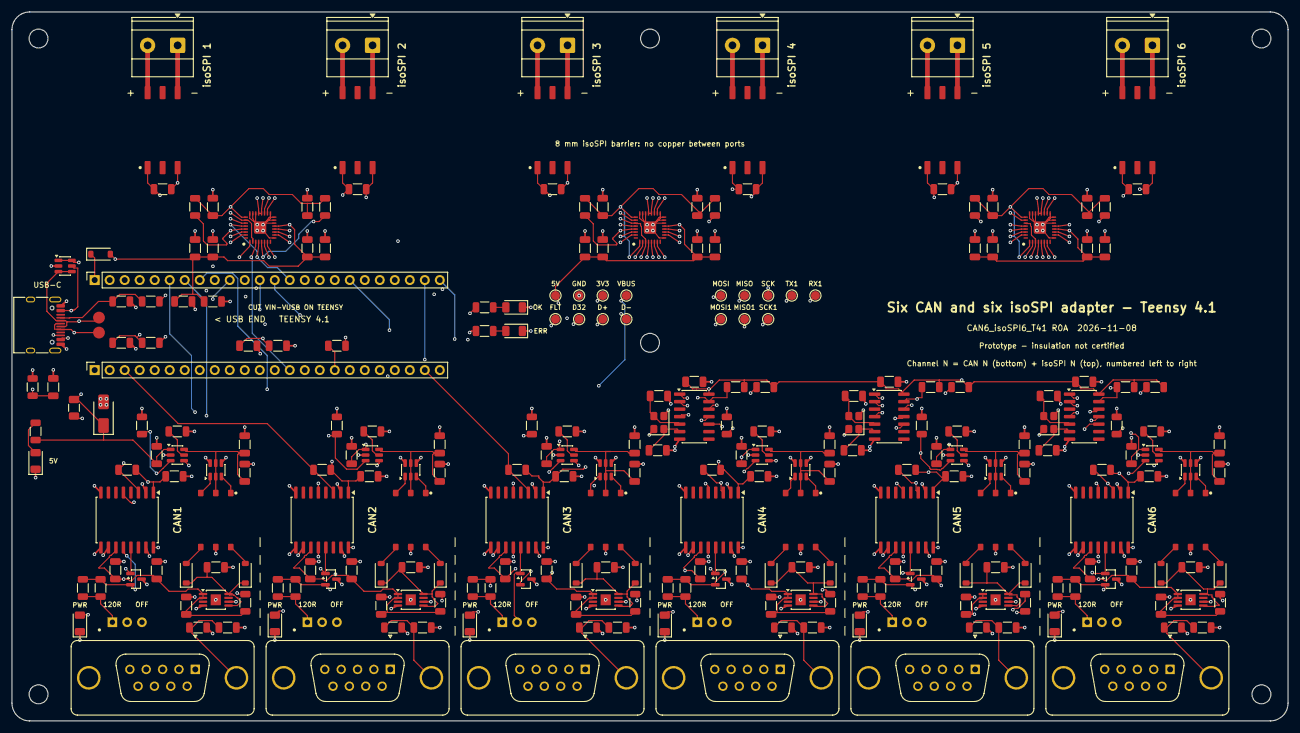
[picture p7: board CAN6_isoSPI6_T41.kicad_pcb from above]

Board: 6 copper layers, 216.0 x 120.0 mm, 276 parts (0 on the bottom side), 175 nets.
