gokberkkatirci/CAN-and-isoSPI-Adapter/hardware/kicad/CAN_isoSPI_adapter.kicad_pcb

## KiCad design hardware/kicad/CAN_isoSPI_adapter.kicad_pcb (2026-11-08)

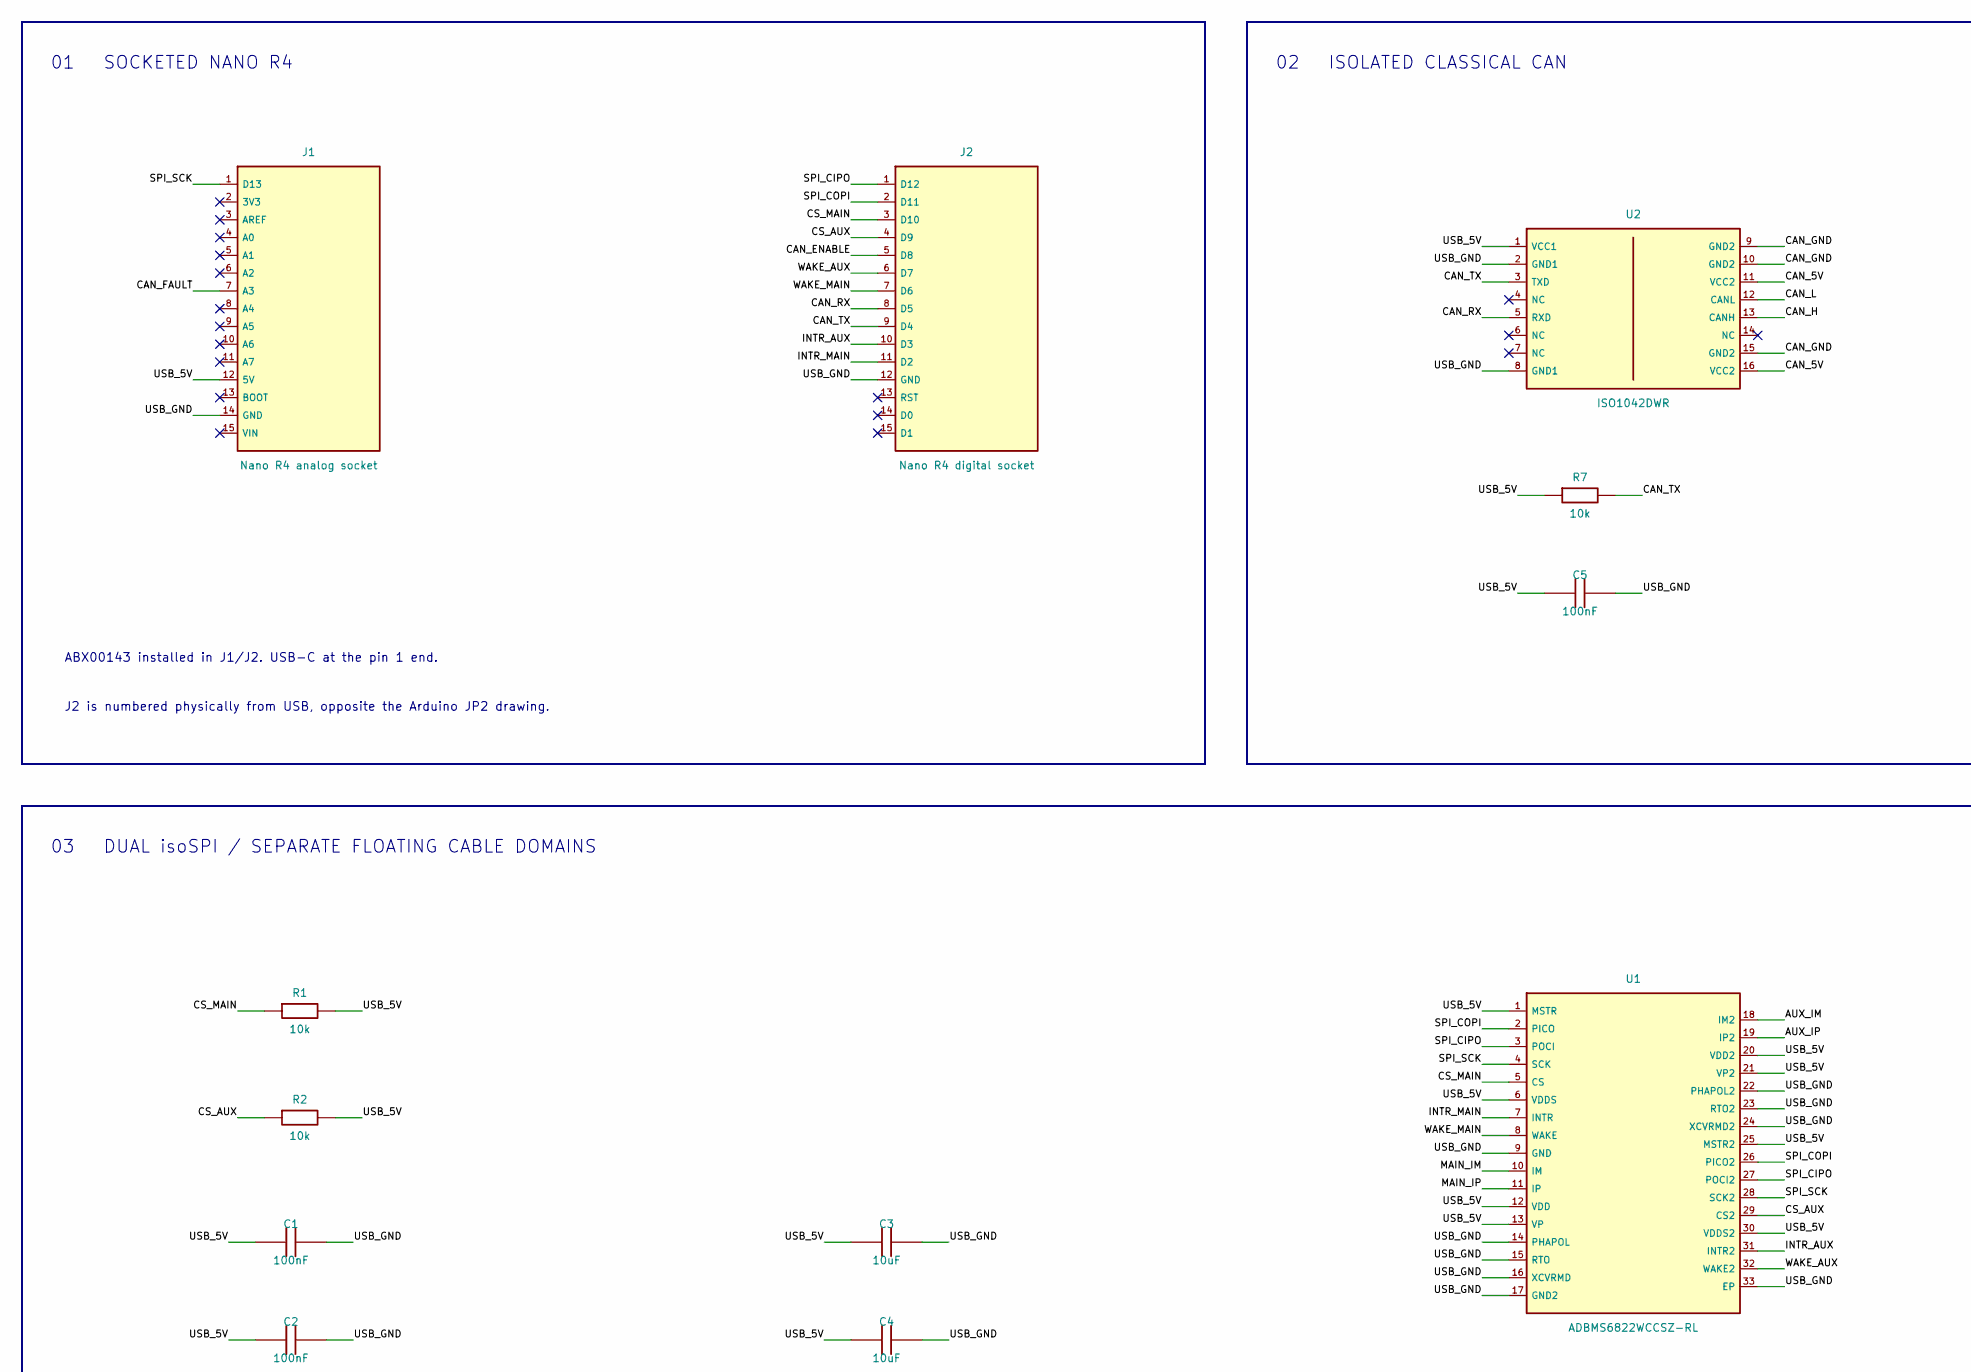
[picture p8: schematic CAN_isoSPI_adapter.kicad_sch, CAN and isoSPI Adapter, part in row 1, column 1]

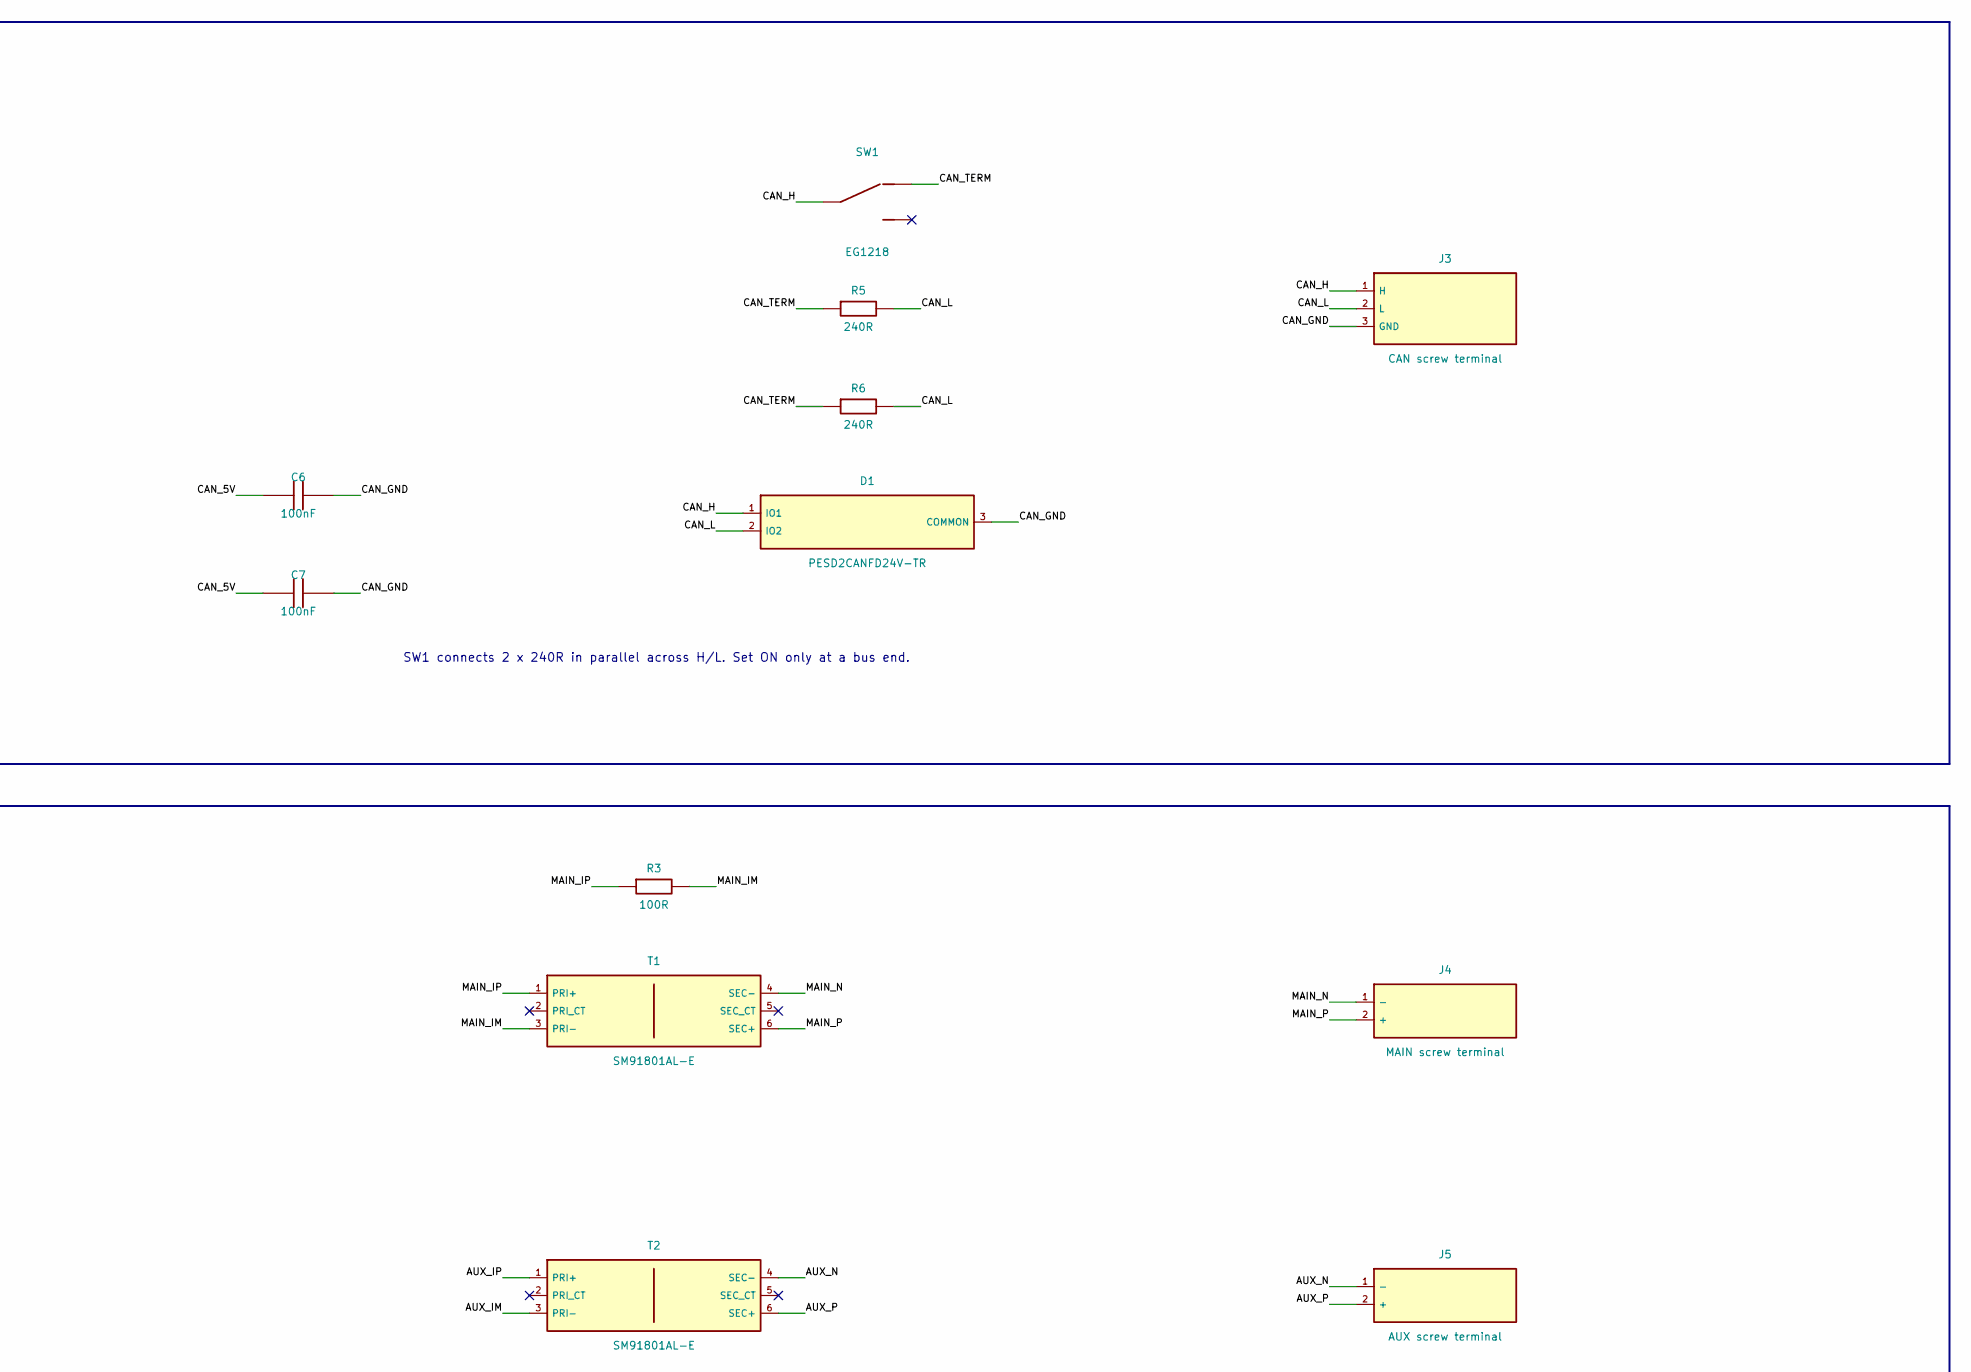
[picture p9: schematic CAN_isoSPI_adapter.kicad_sch, CAN and isoSPI Adapter, part in row 1, column 2]

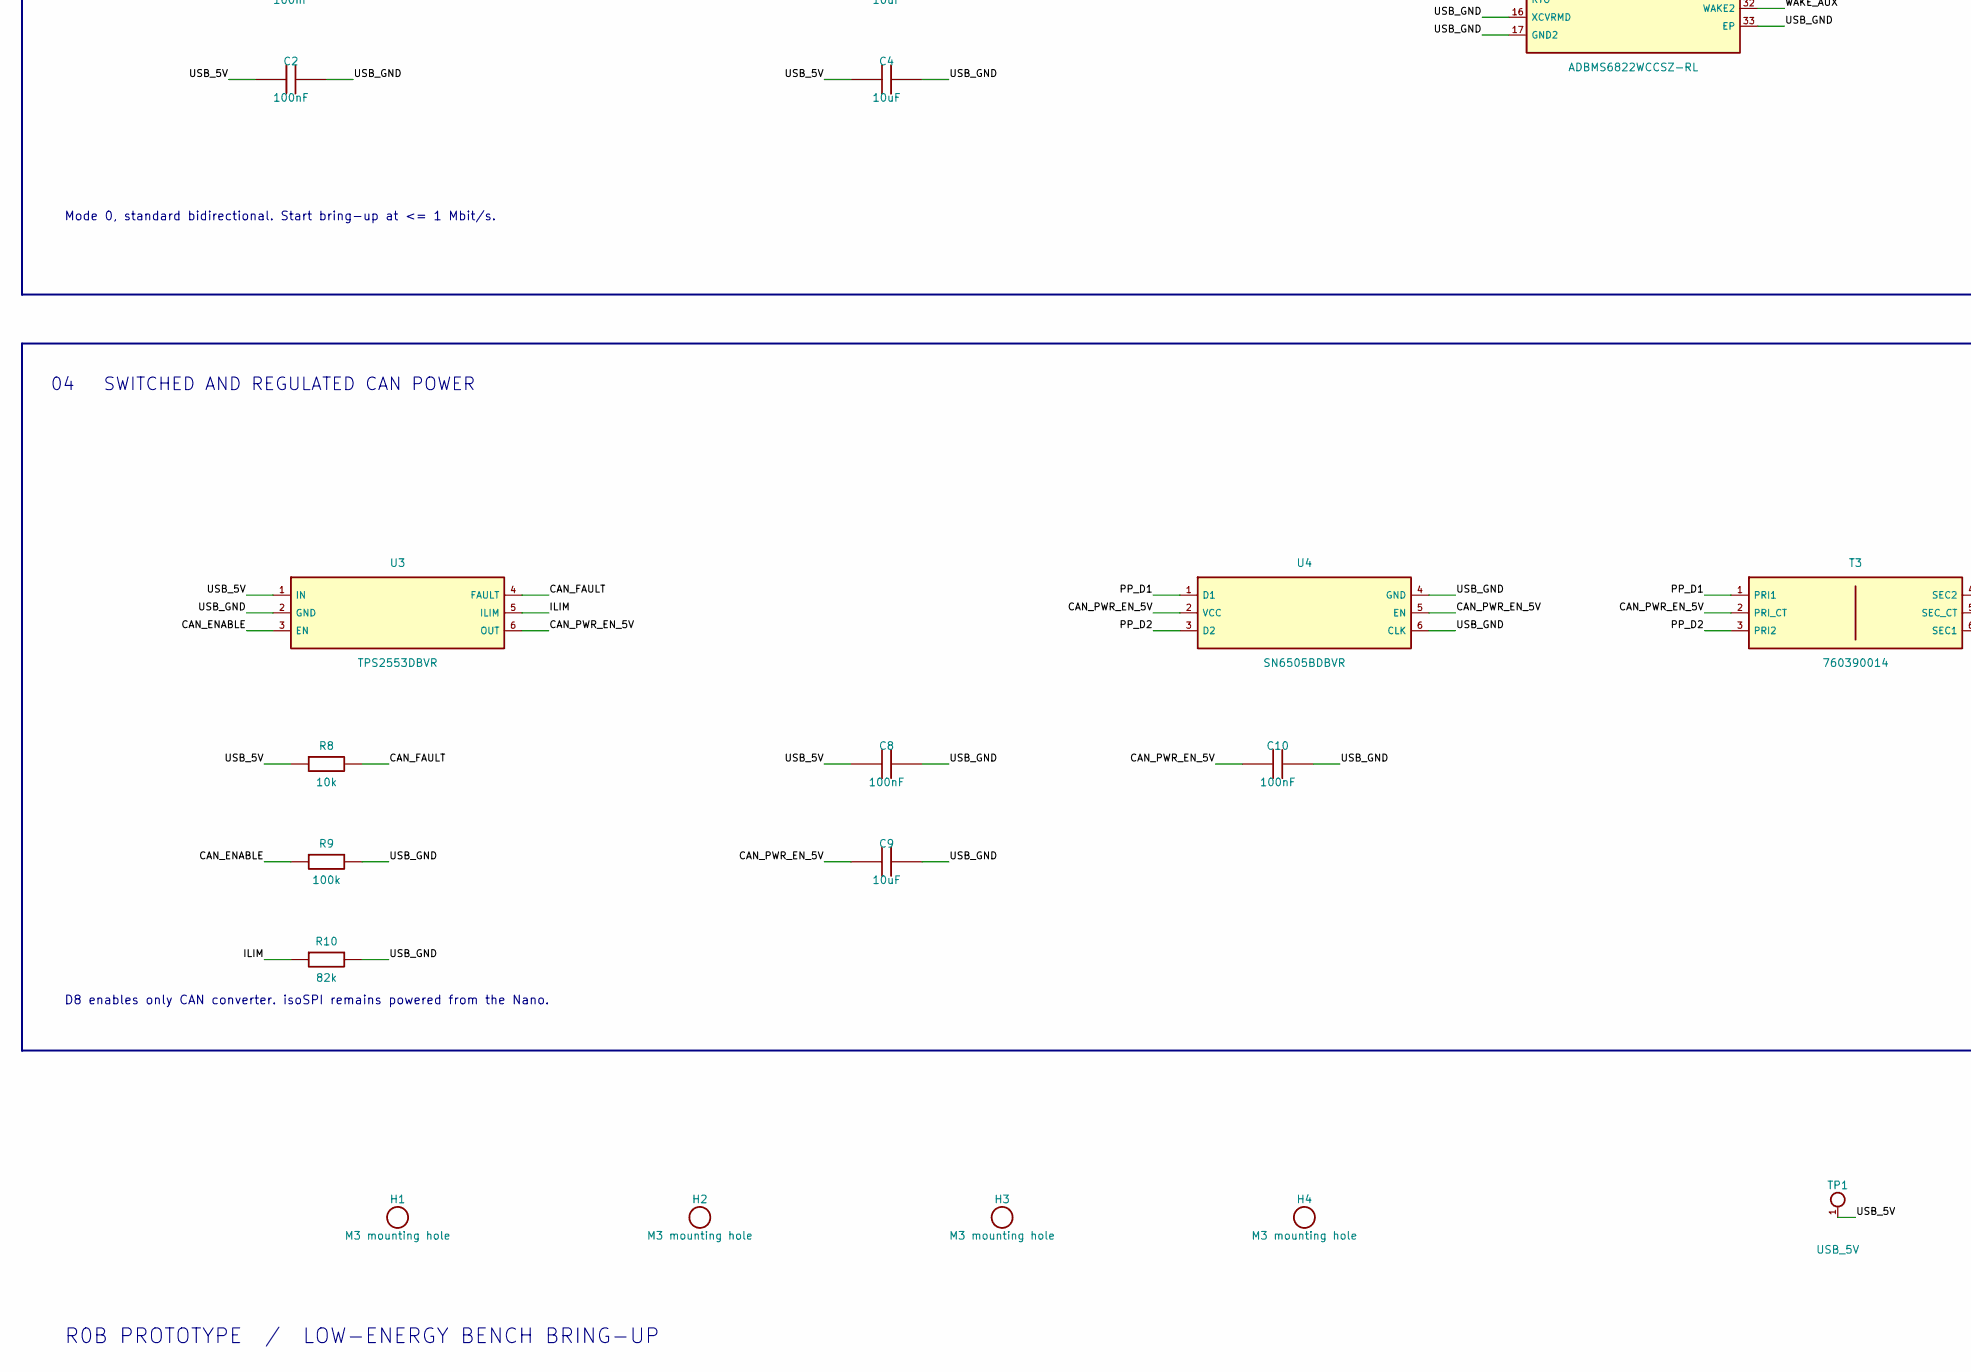
[picture p10: schematic CAN_isoSPI_adapter.kicad_sch, CAN and isoSPI Adapter, part in row 2, column 1]

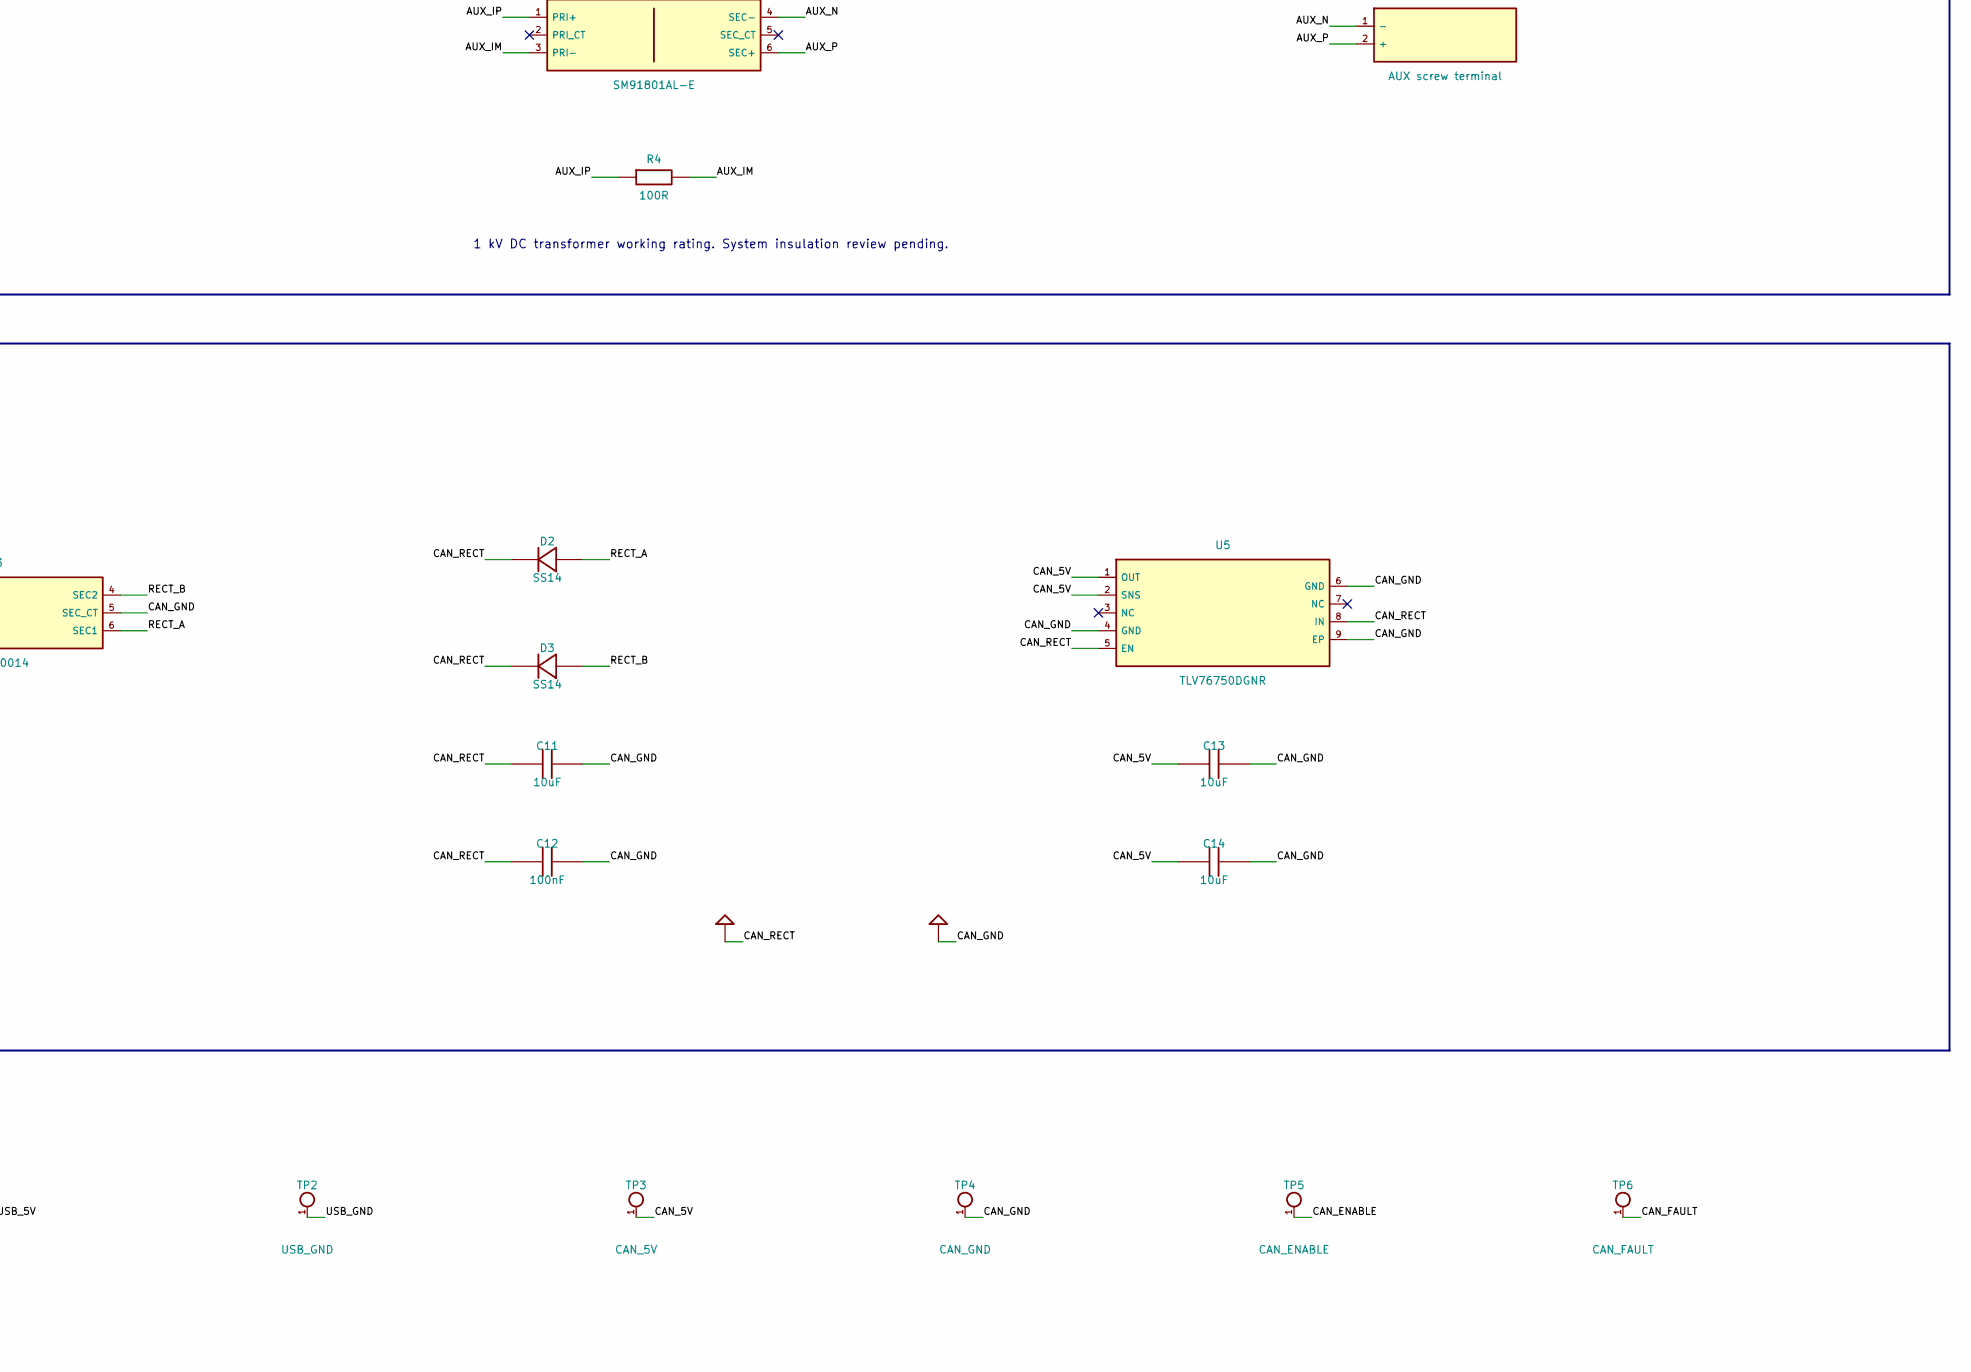
[picture p11: schematic CAN_isoSPI_adapter.kicad_sch, CAN and isoSPI Adapter, part in row 2, column 2]

Parts:
C1, C2, C5, C6, C7, C8, C10, C12: 100nF; C_1206_3216Metric; MPN CL31B104KBCNNNC; JLCPCB Part # C24497
C3, C4, C9, C11, C13, C14: 10uF; C_1206_3216Metric; MPN CL31B106KAHNNNE; JLCPCB Part # C14860
D1: PESD2CANFD24V-TR; SOT-23; MPN PESD2CANFD24V-TR; JLCPCB Part # C552486
D2, D3: SS14; D_SMA; MPN SS14; JLCPCB Part # C2480
H1, H2, H3, H4: M3 mounting hole; MountingHole_3.2mm_M3; MPN Mechanical
J1: Nano R4 analog socket; PinSocket_1x15_P2.54mm_Vertical; MPN SSW-115-01-G-S
J2: Nano R4 digital socket; PinSocket_1x15_P2.54mm_Vertical; MPN SSW-115-01-G-S
J3: CAN screw terminal; TerminalBlock_Phoenix_MKDS-1,5-3-5.08_1x03_P5.08mm_Horizont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; MPN 1715734; JLCPCB Part # C480520
J4: MAIN screw terminal; TerminalBlock_Phoenix_MKDS-1,5-2-5.08_1x02_P5.08mm_Horizont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; MPN 1715721; JLCPCB Part # C480516
J5: AUX screw terminal; TerminalBlock_Phoenix_MKDS-1,5-2-5.08_1x02_P5.08mm_Horizont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; MPN 1715721; JLCPCB Part # C480516
R1, R2, R7, R8: 10k; R_1206_3216Metric; MPN 1206W4F1002T5E; JLCPCB Part # C17902
R3, R4: 100R; R_1206_3216Metric; MPN RC1206FR-07100RL; JLCPCB Part # C137392
R5, R6: 240R; R_1206_3216Metric; MPN 1206W4F2400T5E; JLCPCB Part # C17961
R9: 100k; R_1206_3216Metric; MPN 1206W4F1003T5E; JLCPCB Part # C17900
R10: 82k; R_1206_3216Metric; MPN 1206W4F8202T5E; JLCPCB Part # C17979
SW1: EG1218; MPN EG1218; JLCPCB Part # C273394
T1, T2: SM91801AL-E; MPN SM91801AL-E; JLCPCB Part # C26423704
T3: 760390014; WE_760390014; MPN 760390014; JLCPCB Part # C2802211
TP1: USB_5V; TestPoint_Pad_D1.5mm; MPN USB_5V
TP2: USB_GND; TestPoint_Pad_D1.5mm; MPN USB_GND
TP3: CAN_5V; TestPoint_Pad_D1.5mm; MPN CAN_5V
TP4: CAN_GND; TestPoint_Pad_D1.5mm; MPN CAN_GND
TP5: CAN_ENABLE; TestPoint_Pad_D1.5mm; MPN CAN_ENABLE
TP6: CAN_FAULT; TestPoint_Pad_D1.5mm; MPN CAN_FAULT
U1: ADBMS6822WCCSZ-RL; ADBMS6822_05-08-7057; MPN ADBMS6822WCCSZ-RL; JLCPCB Part # C19190031
U2: ISO1042DWR; SOIC-16W_7.5x10.3mm_P1.27mm; MPN ISO1042DWR; JLCPCB Part # C1848126
U3: TPS2553DBVR; SOT-23-6; MPN TPS2553DBVR; JLCPCB Part # C55266
U4: SN6505BDBVR; SOT-23-6; MPN SN6505BDBVR; JLCPCB Part # C74518
U5: TLV76750DGNR; MSOP-8-1EP_3x3mm_P0.65mm_EP1.73x1.85mm; MPN TLV76750DGNR; JLCPCB Part # C3752807

Connections:
/AUX_IM: R4.2, T2.3 (PRI-), U1.18 (IM2)
/AUX_IP: R4.1, T2.1 (PRI+), U1.19 (IP2)
/AUX_N: J5.1 (-), T2.4 (SEC-)
/AUX_P: J5.2 (+), T2.6 (SEC+)
/CAN_5V: C6.1, C7.1, C13.1, C14.1, TP3.1, U2.11 (VCC2), U2.16 (VCC2), U5.1 (OUT), U5.2 (SNS)
/CAN_ENABLE: J2.5 (D8), R9.1, TP5.1, U3.3 (EN)
/CAN_FAULT: J1.7 (A3), R8.2, TP6.1, U3.4 (FAULT)
/CAN_GND: C6.2, C7.2, C11.2, C12.2, C13.2, C14.2, D1.3 (COMMON), J3.3 (GND), T3.5 (SEC_CT), TP4.1, U2.9 (GND2), U2.10 (GND2), U2.15 (GND2), U5.4 (GND), U5.6 (GND), U5.9 (EP)
/CAN_H: D1.1 (IO1), J3.1 (H), SW1.2 (COM), U2.13 (CANH)
/CAN_L: D1.2 (IO2), J3.2 (L), R5.2, R6.2, U2.12 (CANL)
/CAN_PWR_EN_5V: C9.1, C10.1, T3.2 (PRI_CT), U3.6 (OUT), U4.2 (VCC), U4.5 (EN)
/CAN_RECT: C11.1, C12.1, D2.1 (K), D3.1 (K), U5.5 (EN), U5.8 (IN)
/CAN_RX: J2.8 (D5), U2.5 (RXD)
/CAN_TERM: R5.1, R6.1, SW1.1 (ON)
/CAN_TX: J2.9 (D4), R7.2, U2.3 (TXD)
/CS_AUX: J2.4 (D9), R2.1, U1.29 (CS2)
/CS_MAIN: J2.3 (D10), R1.1, U1.5 (CS)
/ILIM: R10.1, U3.5 (ILIM)
/INTR_AUX: J2.10 (D3), U1.31 (INTR2)
/INTR_MAIN: J2.11 (D2), U1.7 (INTR)
/MAIN_IM: R3.2, T1.3 (PRI-), U1.10 (IM)
/MAIN_IP: R3.1, T1.1 (PRI+), U1.11 (IP)
/MAIN_N: J4.1 (-), T1.4 (SEC-)
/MAIN_P: J4.2 (+), T1.6 (SEC+)
/PP_D1: T3.1 (PRI1), U4.1 (D1)
/PP_D2: T3.3 (PRI2), U4.3 (D2)
/RECT_A: D2.2 (A), T3.6 (SEC1)
/RECT_B: D3.2 (A), T3.4 (SEC2)
/SPI_CIPO: J2.1 (D12), U1.3 (POCI), U1.27 (POCI2)
/SPI_COPI: J2.2 (D11), U1.2 (PICO), U1.26 (PICO2)
/SPI_SCK: J1.1 (D13), U1.4 (SCK), U1.28 (SCK2)
/USB_5V: C1.1, C2.1, C3.1, C4.1, C5.1, C8.1, J1.12 (5V), R1.2, R2.2, R7.1, R8.1, TP1.1, U1.1 (MSTR), U1.6 (VDDS), U1.12 (VDD), U1.13 (VP), U1.20 (VDD2), U1.21 (VP2), U1.25 (MSTR2), U1.30 (VDDS2), U2.1 (VCC1), U3.1 (IN)
/USB_GND: C1.2, C2.2, C3.2, C4.2, C5.2, C8.2, C9.2, C10.2, J1.14 (GND), J2.12 (GND), R9.2, R10.2, TP2.1, U1.9 (GND), U1.14 (PHAPOL), U1.15 (RTO), U1.16 (XCVRMD), U1.17 (GND2), U1.22 (PHAPOL2), U1.23 (RTO2), U1.24 (XCVRMD2), U1.33 (EP), U2.2 (GND1), U2.8 (GND1), U3.2 (GND), U4.4 (GND), U4.6 (CLK)
/WAKE_AUX: J2.6 (D7), U1.32 (WAKE2)
/WAKE_MAIN: J2.7 (D6), U1.8 (WAKE)

Notes on the sheet:
01 SOCKETED NANO R4
02 ISOLATED CLASSICAL CAN
03 DUAL isoSPI / SEPARATE FLOATING CABLE DOMAINS
04 SWITCHED AND REGULATED CAN POWER
ABX00143 installed in J1/J2. USB-C at the pin 1 end.
J2 is numbered physically from USB, opposite the Arduino JP2 drawing.
SW1 connects 2 x 240R in parallel across H/L. Set ON only at a bus end.
Mode 0, standard bidirectional. Start bring-up at <= 1 Mbit/s.
1 kV DC transformer working rating. System insulation review pending.
D8 enables only CAN converter. isoSPI remains powered from the Nano.
R0B PROTOTYPE / LOW-ENERGY BENCH BRING-UP

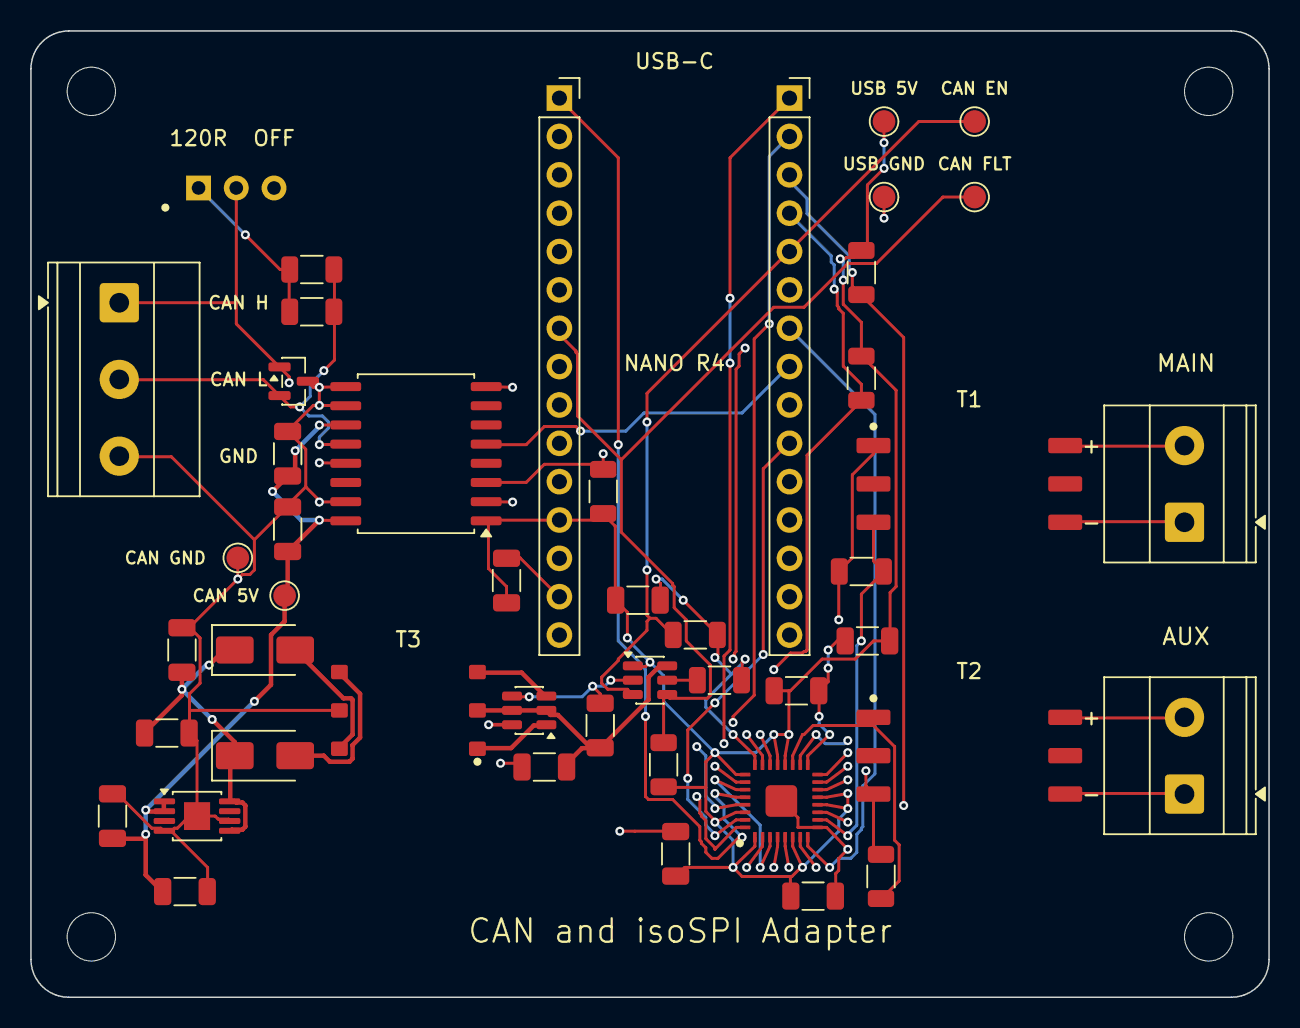
[picture p12: board CAN_isoSPI_adapter.kicad_pcb from above]

Board: 4 copper layers, 82.0 x 64.0 mm, 51 parts (0 on the bottom side), 35 nets.
