gokberkkatirci/CAN-and-isoSPI-Adapter/(commit log)

2026-11-07 Create routed Nano R4 CAN and dual isoSPI prototype
    [GK_CAN_isoSPI_adapter.kicad_pcb, GK_CAN_isoSPI_adapter.kicad_sch, bom-engineering.csv, bom-jlcpcb-smt.csv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]
2026-11-07 Compact adapter layout and add Nano R4 firmware
    [GK_CAN_isoSPI_adapter.kicad_pcb, GK_CAN_isoSPI_adapter.kicad_sch, bom-engineering.csv, bom-jlcpcb-smt.csv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]
2026-11-08 Add Teensy 4.1 six-CAN/six-isoSPI adapter and release Nano board R0C
    Teensy 4.1 adapter (R0A, hardware/teensy41):
    - 216 x 120 mm, six layers, 1206 passives, generated from tools/design.py
    - Six isolated CAN ports (FlexCAN1-3, MCP2518FD x3) on DSUB-9 female
    with PEAK/CiA 303-1 pinout and a 120 ohm switch per port
    - Six isoSPI ports (3x ADBMS6822, SM91801AL-E) opposite their CAN port
    - Single USB-C for power and data via pogo pins to the Teensy USB pads
    - Fully routed; zero ERC, DRC and schematic-parity findings
    - JLCPCB BOM/CPL, Gerbers, 3D models (Teensy, pogo, USB-C) and renders
    - Bridge firmware with per-channel CAN/isoSPI commands and board ID
    Nano R4 adapter R0C:
    - Tie SN6505B CLK to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
    [CAN6_isoSPI6_T41.kicad_pcb, CAN6_isoSPI6_T41.kicad_sch, CAN_isoSPI_adapter.kicad_pcb, CAN_isoSPI_adapter.kicad_sch, GK_CAN_isoSPI_adapter.kicad_pcb, GK_CAN_isoSPI_adapter.kicad_sch, bom-engineering.csv, bom-jlcpcb-smt.csv]
2026-11-08 Add test points, vertical DSUBs, realistic renders and user manual
    Teensy 4.1 board changes:
    - Add 16 test points: power rails, USB D+/D-, both SPI buses,
    CAN1 TX/RX, fault and spare pin
    - Switch to vertical DSUB-9 connectors (Connfly DS1034-09FBN044)
    - Re-route with Freerouting; 0 ERC/DRC/parity findings
    - Regenerate JLCPCB fab files (BOM, CPL, gerbers, checksums)
    3D models and renders:
    - Glossy metal and satin plastic materials on all custom VRML models
    - Detailed Teensy 4.1 model with component layout and gold pins
    - High-quality ray-traced renders with floor and shadows
    Documentation:
    - Add user manual (docs/user-manual-t41.md) covering assembly,
    firmware flashing, USB serial comma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
    [CAN6_isoSPI6_T41.kicad_pcb, CAN6_isoSPI6_T41.kicad_sch, bom-engineering.csv, bom-jlcpcb.csv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]
2026-11-09 Move Teensy silk title block clear of right test points
    The title block sat at x=160 and crowded the MOSI/MISO/SCK/TX1/RX1
    column of test-point labels on the right. Shift all four silk lines
    to x=176, into the open area between the right test-point group
    (rightmost label RX1 at x=136) and the right mounting hole (x=211.5),
    giving a clear ~10 mm gap on each side. Re-render the Teensy top
    and iso views, add a Nano R4 top view, and swap the README hero
    images for both adapters to full top-down views that fill the frame.
    [CAN6_isoSPI6_T41.kicad_pcb]
